ddzuong/In-Wheel-Motor-Testbench-Rebuild/NOTES.md

# Teaching notes

- Người học đang dùng STM32F103CBT6 của WeAct Studio và học lập trình thanh ghi trên KeilC.
- Người học thích kiểm tra bằng debugger và muốn hiểu nguyên nhân ở mức cờ/thanh ghi, không chỉ nhận code mẫu.
- Giải thích bằng tiếng Việt, dùng ví dụ ngắn và liên hệ với UART/Timer đã học.
- Cẩn thận việc KeilC và VS Code có thể hiển thị phiên bản file khác nhau.
- Không sửa source project KeilC nếu người học chưa yêu cầu rõ.
