ddzuong/In-Wheel-Motor-Testbench-Rebuild/docs/images/results/telemetry_dashboard.jpg

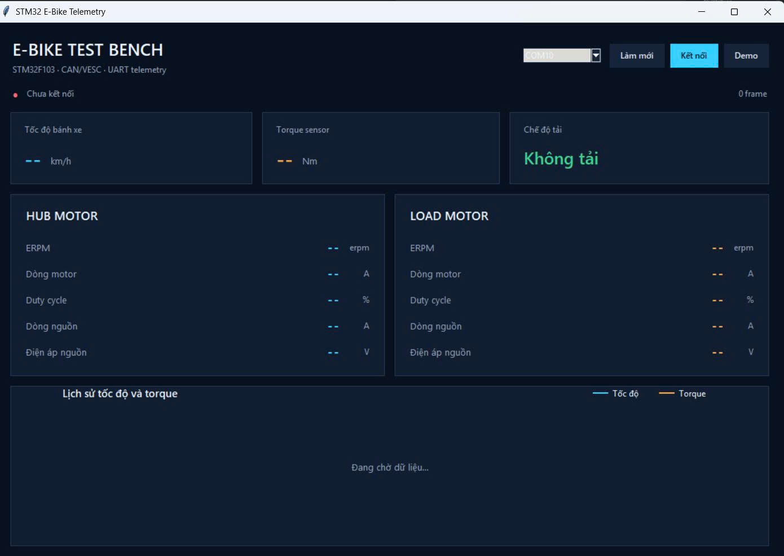
docs/images/results/telemetry_dashboard.jpg
