ddzuong/In-Wheel-Motor-Testbench-Rebuild/Register/Dev/Src/main.h

#ifndef __MAIN_H
#define __MAIN_H

//libc
#include <stdio.h>
#include <stdint.h>
#include <stdbool.h>
#include <string.h>

//Driver code 
#include "rcc.h"
#include "gpio.h"
#include "exti.h"
#include "tim.h"
#include "adc.h"
#include "uart.h"
#include "can.h"
#include "dma.h"


#endif
