ddzuong/In-Wheel-Motor-Testbench-Rebuild/(commit log)

2026-09-22 Add In-Wheel-Motor Testbench Rebuild folder
2026-10-07 Fix DMA_IFCR = (1 << 12) to DMA_IFCR |= (1 << 15);
    [dma.c]
2026-10-07 Clear all Interrupt flag
